amannm/hvac/reference/datasheets/README.md

# Pins
## nRF54
- QFN-40
- Pins: Pages 862-867
- Mechanical: 886

## TLIN1431-Q1
- RGY (VQFN-20)
- Pins: Page 3
- Mechanical: Page 105-107

## AANI
- SMD 0402
- Pins and Mechanical: Page 3
- Resonant Circduit: Page 9
